bald-prince/STM32/official-account-information-master/timer/SOURCE_FILE/README.txt

1.v0.0.1  -->修改了初始化的方式，现在更加简单。
             -->修改了依赖文件，引入stdint.h 该文件里面包含uint8_t 这些变量类型，可以不再依赖于其他的文件。当前只依赖 stdlib 和 stdint这两个文件。都是c的标准文件。
