bald-prince/STM32/STM32_sumjess/HAREWARE/KEY/解释.docx

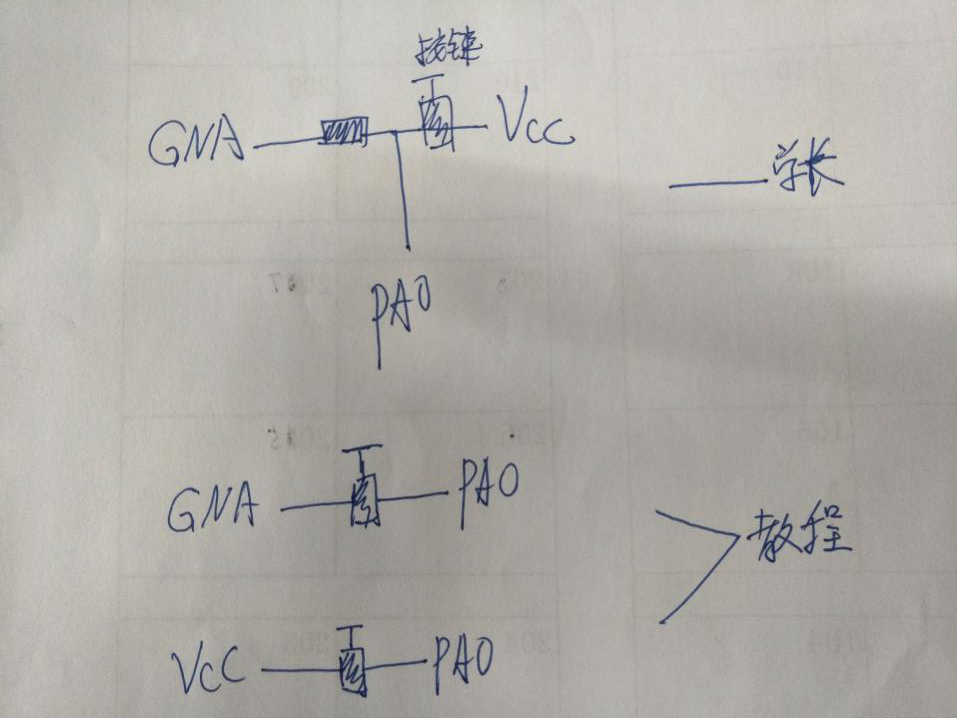
[picture p15: figure]

上拉，然后读取；方法见库中ex-key.

下拉，然后读取；方法见库中ex-key.

直接浮点数读取

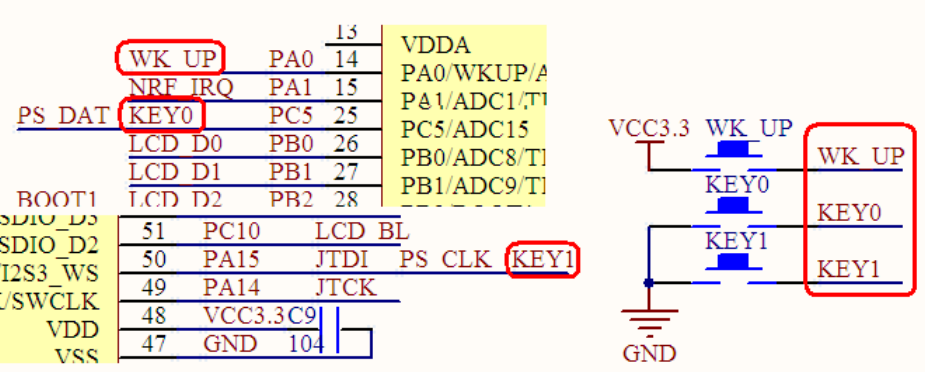
[picture p16: figure]
