bald-prince/STM32/official-account-information-master/RTT_JLINK_Printf/参考文档/HLK-V20固件命令词与播报词格式20200817.xlsx

HLK-V20 固件命令词与播报设置内容
一、唤醒串口参数 |  |  |  | 格式如下：（严格按照该文档要求）以下为默认参数，供参考
1、唤醒词（免唤醒命令词和唤醒词总条数不超过10条）： |  |  |  | 例如：小科小科、小凌小凌、你好魔方、你好台灯、小海小海
2、唤醒回复语（最多4个）： |  |  |  | 例如：我在、 hi！我在；、嗯！我来了 （可设置或不设置）
3、免唤醒的命令词（无需唤醒，说出命令词即可控制设备，需要在添加命令内选择）: |  |  |  | 例如：打开灯、关闭灯 （可设置或不设置）
4、通信波特率（4800 9600 19200 38400 57600 115200可选）： |  |  |  | 例如：115200bps，一位起始位，8位数据位，一位结束位，无校验位。
5、导航播报语（最多30个字）： |  |  |  | 例如：欢迎使用海凌科语音模块 （可设置或不设置）
6、超时退出时间（5-60s）： |  |  |  | 例如：10S （必须设置）
7、超时退出回复（最多两条）： |  |  |  | 例如：有需要再叫我、再见 （可设置或不设置）
8、主动退出退出命令（最多三条）： |  |  |  | 例如：退下、再见、关闭 （可设置或不设置）
9、主动退出回复（最多两条）： |  |  |  | 例如：有需要再叫我、再见 （可设置或不设置）
二、离线命令词与播报答复列表
action | 命令词 | 播报语 | 自定义串口输出协议 | 输出IO口（高低电平或脉冲）
语法格式：action=命令词1|命令词2...@回复语 （action、命令词、回复语均由用户定义） |  |  | 数值为16进制无0x格式 例：00 01 0A（需要空格）数值不超过16个客户可自行定义（可设置可不设置） | 不改代码仅生成固件情况下可用 B0 B1默认为串口输出串口协议 A25 A26 A27 B2 B3 B6 B7引脚为 GPIO 或B2 B3引脚为 PWM A25 A26 A27 B6 B7引脚为 GPIO
text1=风扇调到一档|一挡风|风速调到最小@好的，风扇已调到一档 |  |  |  | B3 PWM设置为40%
text2=增大风速@风速已增加百分之十 |  |  |  | B2 PWM 增加10%
text3=开灯|打开灯@好的，灯已打开 |  |  |  | B2 PWM设置为100%
text4=一小时后开灯|定时一小时开灯@已设置 |  |  | 42 03 01 BC 04 00 00 00 FF 00 03 FB | B7输出高电平
text5=关灯|关闭灯@好的，灯已关闭 |  |  |  | A27输出低电平
text6=打开开关|把开关打开|打开插座@好的 |  |  |  | A25输出周期100ms、次数1次的高电平脉冲（占空比固定为50%）
volumeUpUni=增大音量|加大音量|音量增大|提高音量@好的 |  |  | 4F 00 01
volumeDownUni=减小音量|音量减小@好的 |  |  | 4F 00 02
volumeMinUni=最小音量|音量最小|音量调到最小@好的 |  |  | 4F 00 03
volumeMaxUni=最大音量|音量最大|音量调到最打@好的 |  |  | 4F 00 04
...
...
1. action由英文、下划线“_”和数字组成，必须英文开头，不区分大小写，15个字符内
2. 命令词最多支持150条，每条限 2 - 10 个字符，仅支持中文
3. 一个action最多支持一个”@”定义回复语，单条回复语不得超过500个字符，支持中英文、数字、逗号、句号、问号
4.如果要调整设备音量，请将action设置为volumeUpUni（增大音量）、volumeDownUni（减小音量）、 volumeMaxUni（最大音量）、volumeMidUni（中等音量）、volumeMinUni（最小音量），否则不生效（无法设置静音）
5.IO口设为脉冲时，请提供脉冲的周期以及次数（占空比50%），以及脉冲输出高还是低；PWM设置时，请提供PWM频率以及占空比为高电平或低电平。
 |  |  |  |  | 已减小音量 | 1F
 |  |  |  |  | 已最大音量 | 20
 |  |  |  |  | 已最小音量 | 21
 |  |  |  |  | 风扇已打开 | 22
 |  |  |  |  | 风扇已关闭 | 23
 |  |  |  |  | 风速已调到1档 | 24
 |  |  |  |  | 风速已调到3档 | 25
 |  |  |  |  | 空调已打开 | 26
 |  |  |  |  | 空调已关闭 | 27
 |  |  |  |  | 已设置 | 28
 |  |  |  |  | 已设置 | 29
 |  |  |  |  | 已设置 | 2A
 |  |  |  |  | 已设置 | 2B
 |  |  |  |  | 已设置 | 2C
 |  |  |  |  | 浴霸已打开 | 2D
 |  |  |  |  | 浴霸已关闭 | 2E
 |  |  |  |  | 照明已打开 | 2F
 |  |  |  |  | 照明已关闭 | 30
 |  |  |  |  | 暖气已打开 | 31
 |  |  |  |  | 暖气已关闭 | 32
 |  |  |  |  | 吹风已打开 | 33
 |  |  |  |  | 吹风已关闭 | 34
 |  |  |  |  | 饮水机已打开 | 35
 |  |  |  |  | 饮水机已关闭 | 36
 |  |  |  |  | 好的 | 37
 |  |  |  |  | 好的 | 38
 |  |  |  |  | 电饭煲已打开 | 39
 |  |  |  |  | 电饭煲已关闭 | 3A
 |  |  |  |  | 好的 | 3B
 |  |  |  |  | 好的 | 3C
 |  |  |  |  | 好的 | 3D
 |  |  |  |  | 好的 | 3E
 |  |  |  |  | 开关已打开 | 3F
 |  |  |  |  | 开关已关闭 | 40
 |  |  |  |  | 好的 | 41
 |  |  |  |  | 好的 | 42
 |  |  |  |  | 好的 | 43
 |  |  |  |  | 好的 | 44
 |  |  |  |  | 好的 | 45
 |  |  |  |  | 好的 | 46
 |  |  |  |  | 已设置 | 47
 |  |  |  |  | 已设置 | 48
 |  |  |  |  | 已设置 | 49
 |  |  |  |  | 已设置 | 4A
 |  |  |  |  | 紧急呼叫已打开 | 4B
 |  |  |  |  | 我先离开，主人有事再叫我 | 发送：无 接收：无 | B2输出低电平
