bald-prince/STM32/official-account-information-master/RTT_JLINK_Printf/参考文档/使用说明/使用说明/HLK-V20 Demo固件命令词与播报词 V1.1.xlsx

HLK-V20 demo固件命令词与播报答复介绍
一、操作流程
1、给测试底板通电，模块开机启动后播报“欢迎使用海凌科语音模块”
2、使用默认的唤醒词唤醒，demo演示固件的命令词最多支持150条，一次唤醒可以多次交互
3、唤醒词支持5个：小科小科、小凌小凌、你好魔方、你好台灯、小海小海，唤醒回复语：我在
4、免唤醒的命令词(无需唤醒，说出命令词即可控制设备):打开灯光、关闭灯光
二、离线命令词与播报答复列表
序号 | 命令词 | 播报语 | action(与串口协议相关)
1 | 打开风扇 | 已为您打开风扇 | openElectricfan
2 | 关闭风扇 | 已为您关闭风扇 | closElectricfan
3 | 风扇调到1档 | 好的，风速已调到1档 | AdjustGearmin
 | 1档风
 | 风速调到最小
4 | 风扇调到3档 | 好的，风速已调到3档 | AdjustGearmax
 | 3档风
 | 风速调到最大
5 | 定时一小时关灯 | 已设置 | settiCLonehonor
6 | 定时一小时开灯 | 已设置 | settiOPonehonor
7 | 增大音量 | 好的，已增大音量 | volumeUpUni
 | 加大音量
 | 音量增大
 | 提高音量
8 | 减小音量 | 好的，已减小音量 | volumeDownUni
 | 音量减小
9 | 打开空调 | 已为您打开空调 | openkongtiao
10 | 关闭空调 | 已为您关闭空调 | closekongtiao
11 | 自动模式 | 已设置 | zhidongmos
12 | 制冷模式 | 已设置 | zhilenmos
13 | 制热模式 | 已设置 | zhirmos
14 | 升高温度 | 已设置 | shenggaowendu
15 | 降低温度 | 已设置 | jiandiwendu
16 | 打开台灯 | 台灯已打开 | turnon
17 | 关闭台灯 | 台灯已关闭 | turnoff
18 | 打开灯光 | 已为您打开灯 | openled
 | 开灯
 | 把灯打开
19 | 关灯 | 已为您关闭灯 | closeled
 | 关闭灯光
 | 把灯关闭
20 | 调到最亮 | 好的 | setmaxld
21 | 调到最暗 | 好的 | setminld
22 | 亮一点 | 好的 | zengjialiangdu
 | 增加亮度
23 | 调暗一点 | 好的 | jianxiaoliangdu
 | 减小亮度
24 | 灯调为红色 | 好的 | setcolorred
 | 把灯调为红色
 | 灯红色
 | 红色
25 | 打开浴霸 | 已为您打开浴霸 | dakaiyuba
26 | 关闭浴霸 | 已为您关闭浴霸 | guanbiyuba
27 | 打开照明 | 已为您打开照明 | dakaizaoming
28 | 关闭照明 | 已为您关闭照明 | guanbizhaoming
29 | 打开暖气 | 已为您打开暖气 | dakainuanqi
30 | 关闭暖气 | 已为您关闭暖气 | guanbinuanq
31 | 打开吹风 | 已为您打开吹风 | dakaicfeng
32 | 关闭吹风 | 已为您关闭吹风 | guanbicfeng
33 | 打开饮水机 | 已为您打开饮水机 | dakaiyingsji
34 | 关闭饮水机 | 已为您关闭饮水机 | guanbiyingsji
35 | 开始出水 | 好的 | kaishichus
36 | 停止出水 | 好的 | tingzchus
37 | 打开电饭煲 | 已为您打开电饭煲 | dakdianfangbao
38 | 关闭电饭煲 | 已为您关闭电饭煲 | guabdianfangbao
39 | 保温模式 | 好的 | baowenmos
40 | 煲汤模式 | 好的 | baotangmos
41 | 煮饭模式 | 好的 | zhufangmos
42 | 煮粥模式 | 好的 | zhuzhoumos
43 | 打开开关 | 已为您打开开关 | dakaikaiguan
44 | 关闭开关 | 已为您关闭开关 | guanbikaiguan
45 | 打开杀菌 | 好的 | dakaishaj
46 | 关闭杀菌 | 好的 | guanbishaj
47 | 打开烘干 | 好的 | dakaihonggan
48 | 关闭烘干 | 好的 | guanbihonggan
49 | 打开除臭 | 好的 | dakaichuchou
50 | 关闭除臭 | 好的 | gaunbichuchou
51 | 最大音量 | 好的 | volumeMaxUni
52 | 最小音量 | 好的 | volumeMinUni
53 | 一小时后开机 | 已设置 | settiOonehonor
54 | 一小时后关机 | 已设置 | settiConehonor | settiOonehonor
55 | 温度设置为20度 | 已设置 | tempset20
 | 温度二十度
 | 二十度
56 | 设置十五度 | 已设置 | TempSet15
 | 十五度
 | 温度设置为15度
57 | 退下 | 有需要再叫我 | exitUni
 | 再见
