bald-prince/STM32/(list of files, drawings)

Other design files:
official-account-information-master/HLINK-V20/参考文档/硬件资料/硬件资料/模块封装/HLK-V20 通用PCB封装.PcbLib
official-account-information-master/HLINK-V20/参考文档/硬件资料/硬件资料/模块封装/HLK-V20_PIN 插件PCB封装.PcbLib
official-account-information-master/HLINK-V20/参考文档/硬件资料/硬件资料/模块封装/HLK-V20_SMT 贴片PCB封装.PcbLib
official-account-information-master/HW-TEST/参考文档/硬件资料/硬件资料/模块封装/HLK-V20 通用PCB封装.PcbLib
official-account-information-master/HW-TEST/参考文档/硬件资料/硬件资料/模块封装/HLK-V20_PIN 插件PCB封装.PcbLib
official-account-information-master/HW-TEST/参考文档/硬件资料/硬件资料/模块封装/HLK-V20_SMT 贴片PCB封装.PcbLib
official-account-information-master/RTT_JLINK_Printf/参考文档/硬件资料/硬件资料/模块封装/HLK-V20 通用PCB封装.PcbLib
official-account-information-master/RTT_JLINK_Printf/参考文档/硬件资料/硬件资料/模块封装/HLK-V20_PIN 插件PCB封装.PcbLib
official-account-information-master/RTT_JLINK_Printf/参考文档/硬件资料/硬件资料/模块封装/HLK-V20_SMT 贴片PCB封装.PcbLib
official-account-information-master/STM32最小系统设计/Schlib1.SchLib
official-account-information-master/STM32最小系统设计/ZNXC.PcbDoc
official-account-information-master/STM32最小系统设计/ZNXC.PrjPcb
official-account-information-master/STM32最小系统设计/ZNXC.SchDoc
official-account-information-master/STM32最小系统设计/控制模块.PcbLib
official-account-information-master/STM32最小系统设计/智能小车.SchDoc
official-account-information-master/USB2TTL/USB2TTL/PCB2.PcbDoc
official-account-information-master/USB2TTL/USB2TTL/PCB3.PcbDoc
official-account-information-master/USB2TTL/USB2TTL/PCB_Project1.PrjPCB
official-account-information-master/USB2TTL/USB2TTL/Sheet1.SchDoc
official-account-information-master/USB2TTL/USB2TTL/USB2TTL.PrjPCB
official-account-information-master/USB2TTL/USB2TTL/USB2TTL.SchDoc
official-account-information-master/简易可调电源/LM2596S电源(改)/第一代/MYPOWER_Project.PrjPcb
official-account-information-master/简易可调电源/LM2596S电源(改)/第一代/PcbLib1.PcbLib
official-account-information-master/简易可调电源/LM2596S电源(改)/第一代/Schlib1.SchLib
official-account-information-master/简易可调电源/LM2596S电源(改)/第一代/Sheet1.SchDoc
