bald-prince/STM32/official-account-information-master/RTT_JLINK_Printf/Src/main.c

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
/* Includes ------------------------------------------------------------------*/
#include "main.h"
#include "tim.h"
#include "usart.h"
#include "gpio.h"

/* USER CODE BEGIN Includes */
#include "user_key.h"
#include "user_delay.h"
#include "hcsr04.h"
#include "HLINK_voice.h"
#include "common_interrupt.h"
#include "HW_Remote.h"
#include "stdio.h"
#include "string.h"
#include "SEGGER_RTT.h"

/* USER CODE END Includes */


void SystemClock_Config(void);
/**
  * @brief  The application entry point.
  * @retval int
  */
int main(void)
{
  /* USER CODE BEGIN 1 */
	uint8_t key = 0,t=0,HW_KeyValue = 0;
	float distant = 0;
	int val = 0;
	char *keystr = NULL;
  /* USER CODE END 1 */

  /* MCU Configuration--------------------------------------------------------*/

  /* Reset of all peripherals, Initializes the Flash interface and the Systick. */
  HAL_Init();

  /* Configure the system clock */
  SystemClock_Config();

  /* Initialize all configured peripherals */
  MX_GPIO_Init();
  MX_USART2_UART_Init();
  MX_TIM3_Init();
  MX_USART1_UART_Init();
  MX_TIM2_Init();
  MX_TIM7_Init();
  MX_TIM4_Init();
  /* USER CODE BEGIN 2 */
  HAL_Delay_us_init(168);
  HCSR_TRIG_LOW();
  HAL_GPIO_WritePin(Relay_Ctr_GPIO_Port, Relay_Ctr_Pin, GPIO_PIN_RESET);
  Voice_RecUartInit();
  HAL_TIM_Base_Start(&htim3);
//  HAL_TIM_PWM_Start(&htim3,TIM_CHANNEL_1);
  HAL_TIM_PWM_Start(&htim3,TIM_CHANNEL_3);
//  HAL_TIM_PWM_Start(&htim3,TIM_CHANNEL_2);
	RemoteInit();

  /* USER CODE END 2 */

  /* Infinite loop */
  /* USER CODE BEGIN WHILE */
  while (1)
  {
    /* USER CODE END WHILE */

    /* USER CODE BEGIN 3 */
	
		
		/*********************************************
		//以下是超声波测试代码
		**********************************************/
		//distant =  Distance(5);
		/**********************************************/
		
		/*********************************************
		//以下是按键控制舵机测试代码
		**********************************************/
//		key=KEY_Scan(0);
//		switch (key)
//		{
//			case WKUP_PRES:			//
//				PWM_Output(4,1);
//				printf("rotate -90度\r\n");
//				break;
//			case KEY2_PRES:			//
//				PWM_Output(4,2);
//				printf("rotate -45度\r\n");

//				break;
//			case KEY1_PRES:			// 
//				PWM_Output(4,4);
//				printf("rotate 45度\r\n");
//				break;
//			case KEY0_PRES:			//
//				PWM_Output(4,5);
//				printf("rotate 90度\r\n");	
//				break;
//		}
//		t++;
//		if(t%50==0)
//		{
//			t=0;
//			//printf("\r\n\r\n---------------start--------------------\r\n\r\n");
//			//printf("The Mesure Distant is:%.2f cm\r\n",distant);
//			//printf("\r\n\r\n----------------stop--------------------\r\n\r\n");
//			HAL_GPIO_TogglePin(led_run_GPIO_Port,led_run_Pin);
//		}
//		/**********************************************/
//		
//		/*********************************************
//		//以下是离线语音控制测试代码
//		**********************************************/
//		//Voice_DataFrame();
//		/*********************************************
//		
//		
//		//以下是红外控制舵机测试代码
//		**********************************************/
//		HW_KeyValue=Remote_Scan();
//		
//		if(HW_KeyValue)
//		{
//			keystr = KeyValueConvert(HW_KeyValue);
//			
//			if(!memcmp(keystr,"*",strlen("*")))
//			{
//				PWM_Stop();
//				printf("\r\nrotate stop\r\n");
//			}
//			else if(!memcmp(keystr,"UP",strlen("UP")))
//			{
//				PWM_Output(1,0);
//				PWM_Output(2,0);
//				PWM_Output(3,0);
//				PWM_Output(4,0);
//				printf("\r\nrotate 45度\r\n");
//			}
//			else if(!memcmp(keystr,"RIGHT",strlen("RIGHT")))
//			{
//				PWM_Output(1,45);
//				PWM_Output(2,45);
//				PWM_Output(3,45);
//				PWM_Output(4,45);
//				printf("\r\nrotate 90度\r\n");	
//			}	
//			else if(!memcmp(keystr,"DOWN",strlen("DOWN")))
//			{
//				PWM_Output(1,90);
//				PWM_Output(2,90);
//				PWM_Output(3,90);
//				PWM_Output(4,90);
//				printf("\r\nrotate -45度\r\n");
//			}
//			else if(!memcmp(keystr,"LEFT",strlen("LEFT")))
//			{
//				PWM_Output(1,135);
//				PWM_Output(2,135);
//				PWM_Output(3,135);
//				PWM_Output(4,135);
//				printf("\r\nrotate -90度\r\n");
//			}
//			else if(!memcmp(keystr,"OK",strlen("OK")))
//			{
//				PWM_Output(1,180);
//				PWM_Output(2,180);
//				PWM_Output(3,180);
//				PWM_Output(4,180);
//				printf("\r\nrotate 90度\r\n");
//			}	
//			printf("\r\nThe Key Value is %s \r\n",(char *)(keystr));
//		}
//		/**********************************************/
//		HAL_Delay(10);

	
		SEGGER_RTT_printf(0, RTT_CTRL_TEXT_RED"\r\n欢迎关注小飞哥玩嵌入式\r\n\r\n");
		SEGGER_RTT_printf(0, RTT_CTRL_TEXT_BRIGHT_GREEN"\r\nwelcome Embedded-party\r\n\r\n");
		SEGGER_RTT_printf(0, RTT_CTRL_TEXT_BRIGHT_BLUE"data print test:%f\r\n",12.34);	
		HAL_Delay(500);
  }
  /* USER CODE END 3 */
}

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
