bald-prince/STM32/official-account-information-master/keypad/Core/Inc/main.h

#define KEY2_Pin GPIO_PIN_2
#define KEY2_GPIO_Port GPIOE
#define KEY1_Pin GPIO_PIN_3
#define KEY1_GPIO_Port GPIOE
#define KEY0_Pin GPIO_PIN_4
#define KEY0_GPIO_Port GPIOE
#define Key_ROW1_Pin GPIO_PIN_0
#define Key_ROW1_GPIO_Port GPIOF
#define Key_ROW2_Pin GPIO_PIN_1
#define Key_ROW2_GPIO_Port GPIOF
#define Key_ROW3_Pin GPIO_PIN_2
#define Key_ROW3_GPIO_Port GPIOF
#define Key_ROW4_Pin GPIO_PIN_3
#define Key_ROW4_GPIO_Port GPIOF
#define led1_Pin GPIO_PIN_9
#define led1_GPIO_Port GPIOF
#define led2_Pin GPIO_PIN_10
#define led2_GPIO_Port GPIOF
#define WK_UP_Pin GPIO_PIN_0
#define WK_UP_GPIO_Port GPIOA
#define Key_COL1_Pin GPIO_PIN_0
#define Key_COL1_GPIO_Port GPIOG
#define Key_COL2_Pin GPIO_PIN_1
#define Key_COL2_GPIO_Port GPIOG
#define Key_COL3_Pin GPIO_PIN_2
#define Key_COL3_GPIO_Port GPIOG
#define Key_COL4_Pin GPIO_PIN_3
#define Key_COL4_GPIO_Port GPIOG
#define LCD_DC_Pin GPIO_PIN_6
#define LCD_DC_GPIO_Port GPIOG
#define LCD_CS_Pin GPIO_PIN_7
#define LCD_CS_GPIO_Port GPIOG
#define LCD_RST_Pin GPIO_PIN_8
#define LCD_RST_GPIO_Port GPIOG
