bald-prince/STM32/OLED(u8g2)/HARDWARE/OLED/oled.c

#include "oled.h"
#include "stdlib.h"
#include "delay.h"
#include "oledfont.h"
#include "QR_Encode.h" 



//OLED的显存
//存放格式如下.
//[0]0 1 2 3 ... 127	
//[1]0 1 2 3 ... 127	
//[2]0 1 2 3 ... 127	
//[3]0 1 2 3 ... 127	
//[4]0 1 2 3 ... 127	
//[5]0 1 2 3 ... 127	
//[6]0 1 2 3 ... 127	
//[7]0 1 2 3 ... 127 		   
u8 OLED_GRAM[128][8];	 

//更新显存到LCD		 
void OLED_Refresh_Gram(void)
{
	u8 i,n;		    
	for(i=0;i<8;i++)  
	{  
		OLED_WR_Byte (0xb0+i,OLED_CMD);    //设置页地址（0~7）
		OLED_WR_Byte (0x00,OLED_CMD);      //设置显示位置—列低地址
		OLED_WR_Byte (0x10,OLED_CMD);      //设置显示位置—列高地址   
		for(n=0;n<128;n++)
			OLED_WR_Byte(OLED_GRAM[n][i],OLED_DATA); 
	}   
}
#if OLED_MODE==1	//8080并口
//通过拼凑的方法向OLED输出一个8位数据
//data:要输出的数据
void OLED_Data_Out(u8 data)
{
		u16 dat=data&0X0F;
		GPIOC->ODR&=~(0XF<<6);		//清空6~9
		GPIOC->ODR|=dat<<6;			//D[3:0]-->PC[9:6]
    
    GPIOC->ODR&=~(0X1<<11);		//清空11
    GPIOC->ODR|=((data>>4)&0x01)<<11;
    
    GPIOD->ODR&=~(0X1<<3);		//清空3
    GPIOD->ODR|=((data>>5)&0x01)<<3;
    
    GPIOB->ODR&=~(0X3<<8);		//清空8,9
    GPIOB->ODR|=((data>>6)&0x01)<<8;
    GPIOB->ODR|=((data>>7)&0x01)<<9;
} 
//向SSD1306写入一个字节。
//dat:要写入的数据/命令
//cmd:数据/命令标志 0,表示命令;1,表示数据;
void OLED_WR_Byte(u8 dat,u8 cmd)
{
	OLED_Data_Out(dat);	
 	OLED_RS=cmd;
	OLED_CS=0;	
	OLED_WR=0;	  
	OLED_WR=1;   
	OLED_CS=1;   
	OLED_RS=1;   
} 	    	    
#else
//向SSD1306写入一个字节。
//dat:要写入的数据/命令
//cmd:数据/命令标志 0,表示命令;1,表示数据;
void OLED_WR_Byte(u8 dat,u8 cmd)
{	
	u8 i;			  
	OLED_RS=cmd; //写命令 
	OLED_CS=0;		  
	for(i=0;i<8;i++)
	{			  
		OLED_SCLK=0;
		if(dat&0x80)OLED_SDIN=1;
		else OLED_SDIN=0;
		OLED_SCLK=1;
		dat<<=1;   
	}				 
	OLED_CS=1;		  
	OLED_RS=1;   	  
} 


#endif
	
void OLED_Set_Pos(unsigned char x, unsigned char y) 
{ 
	OLED_WR_Byte(0xb0+y,OLED_CMD);
	OLED_WR_Byte(((x&0xf0)>>4)|0x10,OLED_CMD);
	OLED_WR_Byte((x&0x0f)|0x01,OLED_CMD); 
} 

//开启OLED显示    
void OLED_Display_On(void)
{
	OLED_WR_Byte(0X8D,OLED_CMD);  //SET DCDC命令
	OLED_WR_Byte(0X14,OLED_CMD);  //DCDC ON
	OLED_WR_Byte(0XAF,OLED_CMD);  //DISPLAY ON
}
//关闭OLED显示     
void OLED_Display_Off(void)
{
	OLED_WR_Byte(0X8D,OLED_CMD);  //SET DCDC命令
	OLED_WR_Byte(0X10,OLED_CMD);  //DCDC OFF
	OLED_WR_Byte(0XAE,OLED_CMD);  //DISPLAY OFF
}		   			 
//清屏函数,清完屏,整个屏幕是黑色的!和没点亮一样!!!	  
void OLED_Clear(void)  
{  
	u8 i,n;  
	for(i=0;i<8;i++)for(n=0;n<128;n++)OLED_GRAM[n][i]=0X00;  
	OLED_Refresh_Gram();//更新显示
}
//画点 
//x:0~127
//y:0~63
//t:1 填充 0,清空				   
void OLED_DrawPoint(u8 x,u8 y,u8 t)
{
	u8 pos,bx,temp=0;
	if(x>127||y>63)return;//超出范围了.
	pos=7-y/8;
	bx=y%8;
	temp=1<<(7-bx);
	if(t)OLED_GRAM[x][pos]|=temp;
	else OLED_GRAM[x][pos]&=~temp;	    
}
//x1,y1,x2,y2 填充区域的对角坐标
//确保x1<=x2;y1<=y2 0<=x1<=127 0<=y1<=63	 	 
//dot:0,清空;1,填充	  
void OLED_Fill(u8 x1,u8 y1,u8 x2,u8 y2,u8 dot)  
{  
	u8 x,y;  
	for(x=x1;x<=x2;x++)
	{
		for(y=y1;y<=y2;y++)OLED_DrawPoint(x,y,dot);
	}													    
	OLED_Refresh_Gram();//更新显示
}
//在指定位置显示一个字符,包括部分字符
//x:0~127
//y:0~63
//mode:0,反白显示;1,正常显示				 
//size:选择字体 12/16/24
void OLED_ShowChar(u8 x,u8 y,u8 chr,u8 size,u8 mode)
{      			    
		u8 temp,t,t1;
		u8 y0=y;
		u8 csize=(size/8+((size%8)?1:0))*(size/2);		//得到字体一个字符对应点阵集所占的字节数
		chr=chr-' ';//得到偏移后的值		 
    for(t=0;t<csize;t++)
    {   
		if(size==12)temp=asc2_1206[chr][t]; 	 	//调用1206字体
		else if(size==16)temp=asc2_1608[chr][t];	//调用1608字体
		else if(size==24)temp=asc2_2412[chr][t];	//调用2412字体
		else return;								//没有的字库
        for(t1=0;t1<8;t1++)
		{
			if(temp&0x80)OLED_DrawPoint(x,y,mode);
			else OLED_DrawPoint(x,y,!mode);
			temp<<=1;
			y++;
			if((y-y0)==size)
			{
				y=y0;
				x++;
				break;
			}
		}  	 
    }          
}
//m^n函数
u32 mypow(u8 m,u8 n)
{
	u32 result=1;	 
	while(n--)result*=m;    
	return result;
}				  
//显示2个数字
//x,y :起点坐标	 
//len :数字的位数
//size:字体大小
//mode:模式	0,填充模式;1,叠加模式
//num:数值(0~4294967295);	 		  
void OLED_ShowNum(u8 x,u8 y,u32 num,u8 len,u8 size)
{         	
	u8 t,temp;
	u8 enshow=0;						   
	for(t=0;t<len;t++)
	{
		temp=(num/mypow(10,len-t-1))%10;
		if(enshow==0&&t<(len-1))
		{
			if(temp==0)
			{
				OLED_ShowChar(x+(size/2)*t,y,' ',size,1);
				continue;
			}else enshow=1; 
		 	 
		}
	 	OLED_ShowChar(x+(size/2)*t,y,temp+'0',size,1); 
	}
} 
//显示字符串
//x,y:起点坐标  
//size:字体大小 
//*p:字符串起始地址 
void OLED_ShowString(u8 x,u8 y,const u8 *p,u8 size)
{	
	while((*p>=' '))//判断是不是非法字符!
  {       
		if(x > (128-(size/2) ) )
		{
			x = 0;
			y += size;
		}
    if(y > (64-size) )
		{
			y = x = 0;
			OLED_Clear();
		}
    OLED_ShowChar(x,y,*p,size,1);	 
    x+=size/2;
    p++;
    }  
	
}	
//显示汉字
void OLED_ShowChinese(u8 x,u8 y,u8 chr,u8 size,u8 mode)
{      			    
	u8 temp,t,t1;
	u8 y0=y;
	u8 csize=(size/8+((size%8)?1:0))*size;		//得到字体一个字符对应点阵集所占的字节数
	chr=chr-'0';//得到偏移后的值		 
	for(t=0;t<csize;t++)							//显示点阵库的中的该字符，先通过chr=chr-' '确定字符在点阵库中的行数，接着显示字符所在行的全部数据
	{   
		if(size==16)temp=asc2_1616[chr][t];	//调用1608字体
		 for(t1=0;t1<8;t1++)							//显示显示字符所在行的全部数据
		{
			if(temp&0x80)OLED_DrawPoint(x,y,mode);	//显示一个字节的数据从高位开始开始判断，如果为1则在x,y位置点亮，为0不点亮
			else OLED_DrawPoint(x,y,!mode);
			temp<<=1;   								//左移一位，为扫描下一个点数据
			y++;     										//格点下移
			if((y-y0)==size)            //控制y轴最大扫描数
			{
				y=y0;
				x++;
				break;
			}
		}  	 
	}  	
}

//在指定位置，显示一个24*24大小的汉字
//x,y :汉字的坐标
//index:汉字编号（在字库数组里面的编号） 
void OLED_ShowChinese2424(u16 x,u16 y,u8 index,u8 size)
{
	u8 temp,t,t1;
	u16 y0=y;
	u8 *dzk;   
	u8 csize=(size/8+((size%8)?1:0))*size; //一个24*24的汉字72字节 
	if(size == 12) dzk=(u8*)Chinese_1212[index];        //得到汉字编号对应的点阵库 
	else if(size == 16)	dzk=(u8*)Chinese_1616[index];   //得到汉字编号对应的点阵库 
	else if(size == 24) dzk=(u8*)Chinese_2424[index];   //得到汉字编号对应的点阵库 
//	dzk=(u8*)Chinese_2424[index];        //得到汉字编号对应的点阵库 
	for(t=0;t<csize;t++)
	{                                                                                                      
		temp=dzk[t];                                //得到点阵数据                          
		for(t1=0;t1<8;t1++)                        //按照从高位到低位的顺序画点
		{
			if(temp&0x80)OLED_DrawPoint(x,y,1);
			else OLED_DrawPoint(x,y,0); 
			temp<<=1;
			y++;
			if((y-y0)==size)                        //对y坐标的处理，当y坐标距起始坐标差24个像素点，x坐标加1
			{
				y=y0;
				x++;
				break;
			}
		}           
	}	  
}


/* -------------------------------- begin  -------------------------------- */
/**
  * @Name    OLED_ShowPicture
  * @brief  
  * @param   x: 图片起始X坐标 
**			 y: 图片起始Y坐标 
**			 sizex: 图片长 
**			 sizey: 图片宽 
**			 BMP[]: 图片数组 
**			 mode: 显示模式，0：反色显示；1：正常显示 
  * @retval
  * @author  YCL
  * @Data    2022-05-24
 **/
/* -------------------------------- end -------------------------------- */
void OLED_ShowPicture(u8 x,u8 y,u8 sizex,u8 sizey,u8 BMP[],u8 mode)
{
	u16 j = 0;
	u8 i,n,temp,m;
	u8 x0 = x,y0 = y;
	sizey = sizey/8+((sizey%8?1:0));
	for(n  = 0;n < sizey;n++)
	{
		for(i = 0;i < sizex;i++)
		{
			temp = BMP[j];
			j++;
			for(m = 0;m < 8;m++)
			{
				if(temp&0x01)
					OLED_DrawPoint(x,y,mode);
				else
					OLED_DrawPoint(x,y,!mode);
				temp>>=1;
				y++;
			}
			x++;
			if((x - x0) == sizex)
			{
				x = x0;
				y0 = y0+8;
			}
			 y = y0;
		}
	}
}

//显示二维码，网站长度不能太长，二维码只支持支付宝扫码
void OLED_DrawQRCode(char *website,int mode)
{
//  MAX_MODULESIZE = 33;
//  m_byModuleData[MAX_MODULESIZE][MAX_MODULESIZE];
    u8 i,j;
    EncodeData(website);
    for(i = 0; i < MAX_MODULESIZE; i++)
    {
        for(j = 0; j < MAX_MODULESIZE; j++)
        {
            if(m_byModuleData[i][j] == 1)
            {
            //2倍放大，1个点放大为4个点
                OLED_DrawPoint(2*i, 2*j,mode);
                OLED_DrawPoint(2*i, 2*j+1,mode);        
                OLED_DrawPoint(2*i+1, 2*j,mode);  
                OLED_DrawPoint(2*i+1, 2*j+1,mode);
//            OLED_DrawPoint_QRcode(2*i, 2*j, m_byModuleData[i][j]);
//            OLED_DrawPoint_QRcode(2*i, 2*j+1, m_byModuleData[i][j]);        
//            OLED_DrawPoint_QRcode(2*i+1, 2*j, m_byModuleData[i][j]);  
//            OLED_DrawPoint_QRcode(2*i+1, 2*j+1, m_byModuleData[i][j]);
            }   
        }
    }    
}
    

/*
	@brief			显示动图
	@param			x0：起始列地址
				y0：起始页地址
				x1：终止列地址
				y1：终止页地址
				k: 帧个数
				m: 单帧数组大小
				BMP[][m]：存放动图代码的数组
	@retval			无
 */
void OLED_DrawGIF(unsigned char x0, unsigned char y0,unsigned char x1, unsigned char y1, unsigned char k, int m, unsigned char GIF[][m])
{
	unsigned int j=0; //定义变量
 	unsigned char x,y,i; //定义变量
  
 	if(y1%8==0) y=y1/8;   //判断终止页是否为8的整数倍
 	 else y=y1/8+1;
	for (i=0;i<k;i++) //从第一帧开始画
	{
		j = 0;
		for(y=y0;y<y1;y++) //从起始页开始，画到终止页
		{
			OLED_Set_Pos(x0,y); //在页的起始列开始画
   			
			for(x=x0;x<x1;x++) //画x1 - x0 列
	    {
				OLED_WR_Byte(GIF[i][j++],OLED_DATA);	//画图片的点    	
	    }
		}
	}
}
/*
	@brief			显示图片
	@param			x0：起始列地址
					y0：起始页地址
					x1：终止列地址
					y1：终止页地址
					BMP[]：存放图片代码的数组
	@retval			无
 */

//有频闪
//显示BMP图片128×64起始点坐标(x,y),x的范围0～127，y为页的范围0～7
void OLED_DrawBMP(u8 x0, u8 y0, u8 x1, u8 y1, u8 BMPx[])
{
    u16 j = 0;
    u8 x, y;

    if(y1 % 8 == 0) y = y1 / 8;
    else y = y1 / 8 + 1;
    for(y = y0; y < y1; y++)
    {
        OLED_Set_Pos(x0, y);
        for(x = x0; x < x1; x++)
        {
            //OLED_WriteData(BMPx[j++]);
					OLED_WR_Byte(BMPx[j++],OLED_DATA);
        }
    }
}

void OLED_ShowFloat(u8 x,u8 y,float num,u8 size)//显示float
{
	char temp[10];
  sprintf(temp,"%-5.3f",num);
  OLED_ShowString(x,y,(u8 *)temp,size);
}

//初始化SSD1306					    
void OLED_Init(void)
{ 	 		 
	  GPIO_InitTypeDef GPIO_Initure;
    __HAL_RCC_GPIOA_CLK_ENABLE();   //使能GPIOA时钟
    __HAL_RCC_GPIOB_CLK_ENABLE();   //使能GPIOB时钟
    __HAL_RCC_GPIOC_CLK_ENABLE();   //使能GPIOC时钟
    __HAL_RCC_GPIOD_CLK_ENABLE();   //使能GPIOD时钟
    __HAL_RCC_GPIOE_CLK_ENABLE();   //使能GPIOE时钟
    
#if OLED_MODE==1		//使用8080并口模式		
	
	  //GPIO初始化设置      
    GPIO_Initure.Pin=GPIO_PIN_15;         //PA15
    GPIO_Initure.Mode=GPIO_MODE_OUTPUT_PP;//推挽输出
    GPIO_Initure.Pull=GPIO_PULLUP;        //上拉
    GPIO_Initure.Speed=GPIO_SPEED_FAST;   //快速
    HAL_GPIO_Init(GPIOA,&GPIO_Initure);   //初始化
	
    //PB3,4,7,8,9
    GPIO_Initure.Pin=GPIO_PIN_3|GPIO_PIN_4|GPIO_PIN_7|GPIO_PIN_8|GPIO_PIN_9;	
	  HAL_GPIO_Init(GPIOB,&GPIO_Initure);//初始化

    //PC6,7,8,9,11
    GPIO_Initure.Pin=GPIO_PIN_6|GPIO_PIN_7|GPIO_PIN_8|GPIO_PIN_9|GPIO_PIN_11;	
   	HAL_GPIO_Init(GPIOC,&GPIO_Initure);//初始化	
  
    //PD3
	  GPIO_Initure.Pin=GPIO_PIN_3;	
	  HAL_GPIO_Init(GPIOD,&GPIO_Initure);//初始化	
	
    //PH8
	  GPIO_Initure.Pin=GPIO_PIN_8;	
	  HAL_GPIO_Init(GPIOH,&GPIO_Initure);//初始化	
	
	  OLED_WR=1;
  	OLED_RD=1; 
#else					//使用4线SPI 串口模式
		//GPIO初始化设置      
		GPIO_Initure.Pin=GPIO_PIN_12|GPIO_PIN_11|GPIO_PIN_10;
    GPIO_Initure.Mode=GPIO_MODE_OUTPUT_PP;//推挽输出
    GPIO_Initure.Pull=GPIO_PULLUP;        //上拉
    GPIO_Initure.Speed=GPIO_SPEED_FAST;   //高速
    HAL_GPIO_Init(GPIOB,&GPIO_Initure);//初始化
	
    //PB4,7
    //PC6,7
    GPIO_Initure.Pin=GPIO_PIN_12|GPIO_PIN_13;	
	  HAL_GPIO_Init(GPIOD,&GPIO_Initure);//初始化	

		OLED_SDIN=1;
		OLED_SCLK=1;
#endif
	OLED_CS=1;
	OLED_RS=1;	 
	
	OLED_RST=0;
	delay_ms(100);
	OLED_RST=1; 
					  
	OLED_WR_Byte(0xAE,OLED_CMD); //关闭显示
	OLED_WR_Byte(0xD5,OLED_CMD); //设置时钟分频因子,震荡频率
	OLED_WR_Byte(80,OLED_CMD);   //[3:0],分频因子;[7:4],震荡频率
	OLED_WR_Byte(0xA8,OLED_CMD); //设置驱动路数
	OLED_WR_Byte(0X3F,OLED_CMD); //默认0X3F(1/64) 
	OLED_WR_Byte(0xD3,OLED_CMD); //设置显示偏移
	OLED_WR_Byte(0X00,OLED_CMD); //默认为0
	OLED_WR_Byte(0x40,OLED_CMD); //设置显示开始行 [5:0],行数.										    
	OLED_WR_Byte(0x8D,OLED_CMD); //电荷泵设置
	OLED_WR_Byte(0x14,OLED_CMD); //bit2，开启/关闭
	OLED_WR_Byte(0x20,OLED_CMD); //设置内存地址模式
	OLED_WR_Byte(0x02,OLED_CMD); //[1:0],00，列地址模式;01，行地址模式;10,页地址模式;默认10;
	OLED_WR_Byte(0xA1,OLED_CMD); //段重定义设置,bit0:0,0->0;1,0->127;
	OLED_WR_Byte(0xC0,OLED_CMD); //设置COM扫描方向;bit3:0,普通模式;1,重定义模式 COM[N-1]->COM0;N:驱动路数
	OLED_WR_Byte(0xDA,OLED_CMD); //设置COM硬件引脚配置
	OLED_WR_Byte(0x12,OLED_CMD); //[5:4]配置	 
	OLED_WR_Byte(0x81,OLED_CMD); //对比度设置
	OLED_WR_Byte(0xEF,OLED_CMD); //1~255;默认0X7F (亮度设置,越大越亮)
	OLED_WR_Byte(0xD9,OLED_CMD); //设置预充电周期
	OLED_WR_Byte(0xf1,OLED_CMD); //[3:0],PHASE 1;[7:4],PHASE 2;
	OLED_WR_Byte(0xDB,OLED_CMD); //设置VCOMH 电压倍率
	OLED_WR_Byte(0x30,OLED_CMD); //[6:4] 000,0.65*vcc;001,0.77*vcc;011,0.83*vcc;
	OLED_WR_Byte(0xA4,OLED_CMD); //全局显示开启;bit0:1,开启;0,关闭;(白屏/黑屏)
	OLED_WR_Byte(0xA6,OLED_CMD); //设置显示方式;bit0:1,反相显示;0,正常显示	    						   
	OLED_WR_Byte(0xAF,OLED_CMD); //开启显示	 
	OLED_Clear();
}  

uint8_t u8x8_stm32_gpio_and_delay(U8X8_UNUSED u8x8_t *u8x8,U8X8_UNUSED uint8_t msg, U8X8_UNUSED uint8_t arg_int,U8X8_UNUSED void *arg_ptr)
{
  switch (msg)
  {
		case U8X8_MSG_GPIO_SPI_DATA:
			(arg_int)?SET_BIT(GPIOD->ODR,GPIO_PIN_13):CLEAR_BIT(GPIOD->ODR,GPIO_PIN_13);   //D1
			break;
		case U8X8_MSG_GPIO_SPI_CLOCK:
			(arg_int)?SET_BIT(GPIOD->ODR,GPIO_PIN_12):CLEAR_BIT(GPIOD->ODR,GPIO_PIN_12);
			break;
		case U8X8_MSG_GPIO_AND_DELAY_INIT:
					OLED_Init();
					HAL_Delay(1);
			break;
		case U8X8_MSG_DELAY_MILLI:
			HAL_Delay(arg_int);
			break;
			case U8X8_MSG_GPIO_CS:
				(arg_int)?SET_BIT(GPIOB->ODR,GPIO_PIN_12):CLEAR_BIT(GPIOB->ODR,GPIO_PIN_12);
		case U8X8_MSG_GPIO_DC:
					(arg_int)?SET_BIT(GPIOB->ODR,GPIO_PIN_11):CLEAR_BIT(GPIOB->ODR,GPIO_PIN_11);
			break;
		case U8X8_MSG_GPIO_RESET:
					(arg_int)?SET_BIT(GPIOB->ODR,GPIO_PIN_10):CLEAR_BIT(GPIOB->ODR,GPIO_PIN_10);
			break;
  }
  return 1;
}

void u8g2Init(u8g2_t *u8g2)
{
	u8g2_Setup_ssd1306_128x64_noname_f(u8g2,U8G2_R0,u8x8_byte_4wire_sw_spi,u8x8_stm32_gpio_and_delay);//初始化u8g2
	u8g2_InitDisplay(u8g2); // 根据所选的芯片进行初始化工作，初始化完成后，显示器处于关闭状态
	u8g2_SetPowerSave(u8g2, 0); // 打开显示器
	u8g2_ClearBuffer(u8g2);
}

/*官方提供的Log绘制demo*/
void draw(u8g2_t *u8g2)
{
    u8g2_SetFontMode(u8g2, 1); /*字体模式选择*/
    u8g2_SetFontDirection(u8g2, 0); /*字体方向选择*/
    u8g2_SetFont(u8g2, u8g2_font_inb24_mf); /*字库选择*/
    u8g2_DrawStr(u8g2, 0, 20, "U");
    
    u8g2_SetFontDirection(u8g2, 1);
    u8g2_SetFont(u8g2, u8g2_font_inb30_mn);
    u8g2_DrawStr(u8g2, 21,8,"8");
        
    u8g2_SetFontDirection(u8g2, 0);
    u8g2_SetFont(u8g2, u8g2_font_inb24_mf);
    u8g2_DrawStr(u8g2, 51,30,"g");
    u8g2_DrawStr(u8g2, 67,30,"\xb2");
    
    u8g2_DrawHLine(u8g2, 2, 35, 47);
    u8g2_DrawHLine(u8g2, 3, 36, 47);
    u8g2_DrawVLine(u8g2, 45, 32, 12);
    u8g2_DrawVLine(u8g2, 46, 33, 12);
  
    u8g2_SetFont(u8g2, u8g2_font_4x6_tr);
    u8g2_DrawStr(u8g2, 1,54,"github.com/olikraus/u8g2");
}
