bald-prince/STM32/LED/HARDWARE/LED/led.h

#ifndef _LED_H
#define _LED_H
#include "sys.h"

#define LED0 PCout(0)
#define LED1 PCout(1)
#define LED2 PCout(2)
#define LED3 PCout(3)
#define LED4 PCout(4)
#define LED5 PCout(5)
#define LED6 PCout(6)
#define LED7 PCout(7)


void LED_Init(void);

#endif
