bald-prince/STM32/STM32_sumjess/HAREWARE/LED/LED.c

#include "led.h"

/*******************************************************************************
================================================================================
【平    台】stm32f103zet6_sumjess平台
【编    写】sumjess
【E-mail  】1371129880@qq.com
【软件版本】V2.0
【最后更新】2018年09月06日
【相关信息参考下列地址】
【网    站】
           https://blog.csdn.net/qq_38351824
           http://www.openedv.com/
           http://www.stmcu.org/
					 http://www.firebbs.cn/forum.php
---------------------------------------------------------------------------------
【dev.env.】MDK5.14及以上版本
【Target  】stm32f103zet6
第一次修订：2017/11/09
第二次修订：2018/01/21
第三次修订：2018/09/06
---------------------------------------------------------------------------------
没有完美的代码，只有不断的奉献，大家一起努力；
赠人玫瑰手留余香，欢迎大家反馈bug！
================================================================================
********************************************************************************/	
//LED驱动 代码	       

//初始化PB5和PE5为输出口.并使能这两个口的时钟		    
//LED IO初始化
void LED_Init(void)
{
 
 GPIO_InitTypeDef  GPIO_InitStructure;
 	
 RCC_APB2PeriphClockCmd(RCC_APB2Periph_GPIOD|RCC_APB2Periph_GPIOB, ENABLE);	 //使能PB,PE端口时钟
	
 GPIO_InitStructure.GPIO_Pin = GPIO_Pin_0|GPIO_Pin_12; //LED0-->PB8 LED1-->PB12端口配置
 GPIO_InitStructure.GPIO_Mode = GPIO_Mode_Out_PP; 		 //推挽输出
 GPIO_InitStructure.GPIO_Speed = GPIO_Speed_50MHz;		 //IO口速度为50MHz
 GPIO_Init(GPIOB, &GPIO_InitStructure);					       //根据设定参数初始化GPIOB.8
 GPIO_SetBits(GPIOB,GPIO_Pin_0);						           //PB.8 输出高

 GPIO_InitStructure.GPIO_Pin = GPIO_Pin_13;	    		   //LED1-->PE.2 端口配置, 推挽输出
 GPIO_Init(GPIOD, &GPIO_InitStructure);	  				     //推挽输出 ，IO口速度为50MHz
 GPIO_ResetBits(GPIOD,GPIO_Pin_13); 						           //PE.2 输出高 
}
void relay_Init(void)
{
 
 GPIO_InitTypeDef  GPIO_InitStructure;
 	
 RCC_APB2PeriphClockCmd(RCC_APB2Periph_GPIOD, ENABLE);	 //使能PB,PE端口时钟
	
 GPIO_InitStructure.GPIO_Pin = GPIO_Pin_15; //LED0-->PB8 LED1-->PB12端口配置
 GPIO_InitStructure.GPIO_Mode = GPIO_Mode_Out_PP; 		 //推挽输出
 GPIO_InitStructure.GPIO_Speed = GPIO_Speed_50MHz;		 //IO口速度为50MHz
 GPIO_Init(GPIOD, &GPIO_InitStructure);					       //根据设定参数初始化GPIOB.8
 GPIO_ResetBits(GPIOD,GPIO_Pin_15);						           //PB.8 输出高

}
void light_Init(void)
{
 
 GPIO_InitTypeDef  GPIO_InitStructure;
 	
 RCC_APB2PeriphClockCmd(RCC_APB2Periph_GPIOC, ENABLE);	 //使能PB,PE端口时钟
	
 GPIO_InitStructure.GPIO_Pin = GPIO_Pin_4; //LED0-->PB8 LED1-->PB12端口配置
 GPIO_InitStructure.GPIO_Mode = GPIO_Mode_IN_FLOATING; 		 //推挽输出
 GPIO_InitStructure.GPIO_Speed = GPIO_Speed_50MHz;		 //IO口速度为50MHz
 GPIO_Init(GPIOC, &GPIO_InitStructure);					       //根据设定参数初始化GPIOB.8
 GPIO_ResetBits(GPIOC,GPIO_Pin_4);						           //PB.8 输出高

}  
