bald-prince/STM32/official-account-information-master/LD3320/sensor/User_Device/LD3320_Driver/ld330_drv.c/mp3.h

/******************************************************************************
************************************mp3 data***********************************
* | file      	:	mp3.h
* |	version			:	V1.0
* | date				:	2020-06-18
* | function		:	mp3 data
******************************************************************************/
#ifndef __MP3_H
#define __MP3_H

#define size_sound_1 1235	

//verygood_withHead.mp3
static unsigned char sound_1 [size_sound_1] = {
0x49,0x44,0x33,0x03,0x00,0x00,0x00,0x00,0x01,0x76,0x50,0x52,0x49,0x56,0x00,0x00,
0x00,0x0E,0x00,0x00,0x50,0x65,0x61,0x6B,0x56,0x61,0x6C,0x75,0x65,0x00,0xFF,0x7F,
0x00,0x00,0x50,0x52,0x49,0x56,0x00,0x00,0x00,0x11,0x00,0x00,0x41,0x76,0x65,0x72,
0x61,0x67,0x65,0x4C,0x65,0x76,0x65,0x6C,0x00,0xA1,0x29,0x00,0x00,0x00,0x00,0x00,
0x00,0x00,0x00,0x00,0x00,0x00,0x00,0x00,0x00,0x00,0x00,0x00,0x00,0x00,0x00,0x00,
0x00,0x00,0x00,0x00,0x00,0x00,0x00,0x00,0x00,0x00,0x00,0x00,0x00,0x00,0x00,0x00,
0x00,0x00,0x00,0x00,0x00,0x00,0x00,0x00,0x00,0x00,0x00,0x00,0x00,0x00,0x00,0x00,
0x00,0x00,0x00,0x00,0x00,0x00,0x00,0x00,0x00,0x00,0x00,0x00,0x00,0x00,0x00,0x00,
0x00,0x00,0x00,0x00,0x00,0x00,0x00,0x00,0x00,0x00,0x00,0x00,0x00,0x00,0x00,0x00,
0x00,0x00,0x00,0x00,0x00,0x00,0x00,0x00,0x00,0x00,0x00,0x00,0x00,0x00,0x00,0x00,
0x00,0x00,0x00,0x00,0x00,0x00,0x00,0x00,0x00,0x00,0x00,0x00,0x00,0x00,0x00,0x00,
0x00,0x00,0x00,0x00,0x00,0x00,0x00,0x00,0x00,0x00,0x00,0x00,0x00,0x00,0x00,0x00,
0x00,0x00,0x00,0x00,0x00,0x00,0x00,0x00,0x00,0x00,0x00,0x00,0x00,0x00,0x00,0x00,
0x00,0x00,0x00,0x00,0x00,0x00,0x00,0x00,0x00,0x00,0x00,0x00,0x00,0x00,0x00,0x00,
0x00,0x00,0x00,0x00,0x00,0x00,0x00,0x00,0x00,0x00,0x00,0x00,0x00,0x00,0x00,0x00,
0x00,0x00,0x00,0x00,0x00,0x00,0x00,0x00,0x00,0x00,0x00,0x00,0x00,0x00,0x00,0x00,
0xFF,0xE2,0x10,0xC0,0x0B,0xC1,0x00,0x07,0xF0,0x4E,0x80,0xD0,0x61,0x86,0x28,0xF3,
0xF6,0x00,0x6E,0x04,0x0E,0x4C,0xD7,0xB4,0x11,0x1C,0x82,0x17,0x76,0xC9,0x31,0x13,
0xE5,0x1C,0x18,0x5C,0x83,0xC6,0xBC,0x85,0xDB,0x91,0x3E,0x30,0x07,0x3E,0x53,0x25,
0x1C,0x16,0x0D,0x3E,0xFF,0xE2,0x10,0xC0,0x6C,0x92,0x05,0x08,0x28,0x56,0xC5,0x71,
0x4F,0x00,0x00,0x0C,0xE2,0xCE,0x23,0x6A,0x07,0xEC,0x0C,0xF1,0xDE,0x6B,0xC0,0x64,
0xCC,0x7B,0xC9,0x10,0x06,0x3C,0xFF,0xFF,0xFD,0xB1,0x50,0x20,0x20,0x5C,0xD7,0x04,
0x02,0x76,0x3A,0x95,0x88,0xF7,0x31,0xBE,0xFF,0xE2,0x12,0xC0,0x4A,0xC1,0x09,0x05,
0xB0,0x36,0xF4,0x29,0x89,0x00,0x00,0x41,0xD4,0x87,0xE8,0xFB,0xBF,0xFF,0xFF,0xE8,
0x08,0x9F,0xFF,0xD6,0x5F,0x68,0x0F,0x76,0xCD,0x0C,0x92,0x7D,0x0F,0x6E,0x54,0x82,
0xCA,0x7F,0xFF,0xFF,0xFF,0x3A,0xB1,0xE0,0xB2,0x02,0xC7,0xED,0x79,0xFF,0xE2,0x10,
0xC0,0xB5,0x38,0x18,0x07,0x90,0x47,0x04,0xB1,0xC7,0x00,0x00,0x91,0x03,0xCE,0x0A,
0x82,0x04,0x1F,0x80,0x04,0x01,0x47,0xF8,0x6B,0xC2,0x0F,0xFF,0x08,0x0F,0x6A,0x89,
0x8A,0x7F,0xFF,0xFF,0xFC,0x11,0x89,0x0C,0x8A,0x09,0x9C,0xD0,0xC4,0x42,0x6D,0x0F,
0x49,0xFF,0xE2,0x10,0xC0,0xE7,0xFC,0x1E,0x07,0xA0,0x76,0xFD,0x70,0x39,0x4A,0x48,
0x6D,0x90,0x86,0x80,0xFC,0x7E,0x0D,0xBD,0xF2,0x5D,0x4D,0xD0,0x26,0x20,0x58,0x17,
0xFF,0xEB,0x7C,0x4C,0x02,0xEA,0x48,0x2A,0xE9,0x8D,0x3F,0x60,0x1A,0x82,0xC0,0x7E,
0x22,0x09,0xEF,0x90,0xC7,0xFF,0xE2,0x10,0xC0,0xA4,0xC6,0x24,0x06,0x58,0x73,0x09,
0x90,0x10,0x4A,0x48,0xC9,0x30,0xCA,0xC6,0x06,0xD1,0xE1,0xAF,0xFE,0xB1,0xA8,0x38,
0x03,0x08,0x9D,0x20,0x84,0x4A,0x40,0x2C,0x7F,0x06,0x00,0x37,0x20,0x70,0x37,0xB1,
0x85,0x80,0x00,0x41,0x61,0xA2,0x0A,0x71,0x13,0xFF,0xE2,0x12,0xC0,0xE9,0x5B,0x2F,
0x06,0x78,0x6F,0x01,0x90,0x28,0x50,0x48,0x3B,0x3A,0x7F,0xFF,0xFF,0xFF,0xFF,0x4B,
0xAB,0x6F,0xB3,0xB1,0x99,0x50,0x47,0x0C,0xA5,0xF2,0x26,0x8A,0x02,0x3E,0xA5,0xE6,
0x23,0x3A,0x16,0xB0,0x87,0x29,0x86,0x5D,0x07,0xFC,0x86,0x8A,0xD4,0x04,0xFF,0xE2,
0x10,0xC0,0x4E,0x21,0x3B,0x09,0xC9,0x67,0x05,0x90,0x11,0x44,0x91,0x63,0x53,0xFF,
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
};

#endif
