bald-prince/STM32/STM32_sumjess/explain/ex-lcd.c

/*

*******************************************************************************
================================================================================
【平    台】stm32f103zet6_sumjess平台
【编    写】sumjess
【E-mail  】1371129880@qq.com
【软件版本】V2.0
【最后更新】2018年01月21日
【相关信息参考下列地址】
【网    站】http://www.openedv.com/
           http://www.stmcu.org/
					 http://www.firebbs.cn/forum.php
---------------------------------------------------------------------------------
【dev.env.】MDK5.14及以上版本
【Target  】stm32f103zet6
第一次修订：2017/11/09
第二次修订：2018/01/21
---------------------------------------------------------------------------------
没有完美的代码，只有不断的奉献，大家一起努力；
赠人玫瑰手留余香，欢迎大家反馈bug！
================================================================================
********************************************************************************





#include "led.h"
#include "delay.h"
#include "sys.h"
#include "usart.h"
#include "lcd.h"


 int main(void)
 { 
	 u8 x=0;
	u8 lcd_id[12];			//存放LCD ID字符串	
	delay_init();	    	 //延时函数初始化	  
	uart_init(9600);	 	//串口初始化为9600
	LED_Init();		  		//初始化与LED连接的硬件接口
 	LCD_Init();
	POINT_COLOR=RED; 
	sprintf((char*)lcd_id,"LCD ID:%04X",lcddev.id);//将LCD ID打印到lcd_id数组。				 	
  	while(1) 
	{		 
		switch(x)
		{
			case 0:LCD_Clear(WHITE);break;
			case 1:LCD_Clear(BLACK);break;
			case 2:LCD_Clear(BLUE);break;
			case 3:LCD_Clear(RED);break;
			case 4:LCD_Clear(MAGENTA);break;
			case 5:LCD_Clear(GREEN);break;
			case 6:LCD_Clear(CYAN);break;

			case 7:LCD_Clear(YELLOW);break;
			case 8:LCD_Clear(BRRED);break;
			case 9:LCD_Clear(GRAY);break;
			case 10:LCD_Clear(LGRAY);break;
			case 11:LCD_Clear(BROWN);break;
		}
		POINT_COLOR=RED;	  
		LCD_ShowString(30,40,200,24,24,"Mini STM32 ^_^");	
		LCD_ShowString(30,70,200,16,16,"TFTLCD TEST");
		LCD_ShowString(30,90,200,16,16,"sumjess");
 		LCD_ShowString(30,110,200,16,16,lcd_id);		//显示LCD ID	      					 
		LCD_ShowString(30,130,200,12,12,"2014/3/7");	      					 
	    x++;
		if(x==12)x=0;
		LED0=!LED0;	 
		delay_ms(1000);	
	} 
}





*/
