bald-prince/STM32/OLED(GuiLite)/Hello_Cricle/GuiLite.h

#pragma once
#define REAL_TIME_TASK_CYCLE_MS		50
#define MAX(a,b) (((a)>(b))?(a):(b))
#define MIN(a,b) (((a)<(b))?(a):(b))
#define GL_ARGB(a, r, g, b) ((((unsigned int)(a)) << 24) | (((unsigned int)(r)) << 16) | (((unsigned int)(g)) << 8) | ((unsigned int)(b)))
#define GL_ARGB_A(rgb) ((((unsigned int)(rgb)) >> 24) & 0xFF)
#define GL_RGB(r, g, b) ((0xFF << 24) | (((unsigned int)(r)) << 16) | (((unsigned int)(g)) << 8) | ((unsigned int)(b)))
#define GL_RGB_R(rgb) ((((unsigned int)(rgb)) >> 16) & 0xFF)
#define GL_RGB_G(rgb) ((((unsigned int)(rgb)) >> 8) & 0xFF)
#define GL_RGB_B(rgb) (((unsigned int)(rgb)) & 0xFF)
#define GL_RGB_32_to_16(rgb) (((((unsigned int)(rgb)) & 0xFF) >> 3) | ((((unsigned int)(rgb)) & 0xFC00) >> 5) | ((((unsigned int)(rgb)) & 0xF80000) >> 8))
#define GL_RGB_16_to_32(rgb) ((0xFF << 24) | ((((unsigned int)(rgb)) & 0x1F) << 3) | ((((unsigned int)(rgb)) & 0x7E0) << 5) | ((((unsigned int)(rgb)) & 0xF800) << 8))
#define ALIGN_HCENTER		0x00000000L
#define ALIGN_LEFT			0x01000000L
#define ALIGN_RIGHT			0x02000000L
#define ALIGN_HMASK			0x03000000L
#define ALIGN_VCENTER		0x00000000L
#define ALIGN_TOP			0x00100000L
#define ALIGN_BOTTOM		0x00200000L
#define ALIGN_VMASK			0x00300000L
typedef struct
{
	unsigned short year;
	unsigned short month;
	unsigned short date;
	unsigned short day;
	unsigned short hour;
	unsigned short minute;
	unsigned short second;
}T_TIME;
void register_debug_function(void(*my_assert)(const char* file, int line), void(*my_log_out)(const char* log));
void _assert(const char* file, int line);
#define ASSERT(condition)	\
	do{                     \
	if(!(condition))_assert(__FILE__, __LINE__);\
	}while(0)
void log_out(const char* log);
long get_time_in_second();
T_TIME second_to_day(long second);
T_TIME get_time();
void start_real_timer(void (*func)(void* arg));
void register_timer(int milli_second, void func(void* param), void* param);
unsigned int get_cur_thread_id();
void create_thread(unsigned long* thread_id, void* attr, void *(*start_routine) (void *), void* arg);
void thread_sleep(unsigned int milli_seconds);
int build_bmp(const char *filename, unsigned int width, unsigned int height, unsigned char *data);
#define FIFO_BUFFER_LEN		1024
class c_fifo
{
public:
	c_fifo();
	int read(void* buf, int len);
	int write(void* buf, int len);
private:
	unsigned char 	m_buf[FIFO_BUFFER_LEN];
	int		m_head;
	int		m_tail;
	void* m_read_sem;
	void* m_write_mutex;
};
class c_rect
{
public:
	c_rect(){ m_left = m_top = m_right = m_bottom = -1; }
	c_rect(int left, int top, int width, int height)
	{
		set_rect(left, top, width, height);
	}
	void set_rect(int left, int top, int width, int height)
	{
		ASSERT(width > 0 && height > 0);
		m_left = left;
		m_top = top;
		m_right = left + width - 1;
		m_bottom = top + height -1;
	}
	bool pt_in_rect(int x, int y) const
	{
		return x >= m_left && x <= m_right && y >= m_top && y <= m_bottom;
	}
	int operator==(const c_rect& rect) const
	{
		return (m_left == rect.m_left) && (m_top == rect.m_top) && (m_right == rect.m_right) && (m_bottom == rect.m_bottom);
	}
	int width() const { return m_right - m_left + 1; }
	int height() const { return m_bottom - m_top + 1 ; }
	int	    m_left;
	int     m_top;
	int     m_right;
	int     m_bottom;
};
//BITMAP
typedef struct struct_bitmap_info
{
	unsigned short width;
	unsigned short height;
	unsigned short color_bits;//support 16 bits only
	const unsigned short* pixel_color_array;
} BITMAP_INFO;
//FONT
typedef struct struct_lattice
{
	unsigned int			utf8_code;
	unsigned char			width;
	const unsigned char*	pixel_buffer;
} LATTICE;
typedef struct struct_lattice_font_info
{
	unsigned char	height;
	unsigned int	count;
	LATTICE*		lattice_array;
} LATTICE_FONT_INFO;
//Rebuild gui library once you change this file
enum FONT_LIST
{
	FONT_NULL,
	FONT_DEFAULT,
	FONT_CUSTOM1,
	FONT_CUSTOM2,
	FONT_CUSTOM3,
	FONT_CUSTOM4,
	FONT_CUSTOM5,
	FONT_CUSTOM6,
	FONT_MAX
};
enum IMAGE_LIST
{
	IMAGE_CUSTOM1,
	IMAGE_CUSTOM2,
	IMAGE_CUSTOM3,
	IMAGE_CUSTOM4,
	IMAGE_CUSTOM5,
	IMAGE_CUSTOM6,
	IMAGE_MAX
};
enum COLOR_LIST
{
	COLOR_WND_FONT,
	COLOR_WND_NORMAL,
	COLOR_WND_PUSHED,
	COLOR_WND_FOCUS,
	COLOR_WND_BORDER,
	COLOR_CUSTOME1,
	COLOR_CUSTOME2,
	COLOR_CUSTOME3,
	COLOR_CUSTOME4,
	COLOR_CUSTOME5,
	COLOR_CUSTOME6,
	COLOR_MAX
};
class c_theme
{
public:
	static int add_font(FONT_LIST index, const void* font)
	{
		if (index >= FONT_MAX)
		{
			ASSERT(false);
			return -1;
		}
		s_font_map[index] = font;
		return 0;
	}
	static const void* get_font(FONT_LIST index)
	{
		if (index >= FONT_MAX)
		{
			ASSERT(false);
			return 0;
		}
		return s_font_map[index];
	}
	static int add_image(IMAGE_LIST index, const void* image_info)
	{
		if (index >= IMAGE_MAX)
		{
			ASSERT(false);
			return -1;
		}
		s_image_map[index] = image_info;
		return 0;
	}
	static const void* get_image(IMAGE_LIST index)
	{
		if (index >= IMAGE_MAX)
		{
			ASSERT(false);
			return 0;
		}
		return s_image_map[index];
	}
	
	static int add_color(COLOR_LIST index, const unsigned int color)
	{
		if (index >= COLOR_MAX)
		{
			ASSERT(false);
			return -1;
		}
		s_color_map[index] = color;
		return 0;
	}
	static const unsigned int get_color(COLOR_LIST index)
	{
		if (index >= COLOR_MAX)
		{
			ASSERT(false);
			return 0;
		}
		return s_color_map[index];
	}
private:
	static const void* s_font_map[FONT_MAX];
	static const void* s_image_map[IMAGE_MAX];
	static unsigned int s_color_map[COLOR_MAX];
};
#include <string.h>
#include <stdio.h>
#include <stdlib.h>
#define SURFACE_CNT_MAX	6//root + pages
typedef enum
{
	Z_ORDER_LEVEL_0,//lowest graphic level
	Z_ORDER_LEVEL_1,//middle graphic level
	Z_ORDER_LEVEL_2,//highest graphic level
	Z_ORDER_LEVEL_MAX
}Z_ORDER_LEVEL;
struct DISPLAY_DRIVER
{
	void(*draw_pixel)(int x, int y, unsigned int rgb);
	void(*fill_rect)(int x0, int y0, int x1, int y1, unsigned int rgb);
};
class c_surface;
class c_display {
	friend class c_surface;
public:
	inline c_display(void* phy_fb, int display_width, int display_height, c_surface* surface, DISPLAY_DRIVER* driver = 0);//single custom surface
	inline c_display(void* phy_fb, int display_width, int display_height, int surface_width, int surface_height, unsigned int color_bytes, int surface_cnt, DISPLAY_DRIVER* driver = 0);//multiple surface
	inline c_surface* alloc_surface(Z_ORDER_LEVEL max_zorder, c_rect layer_rect = c_rect());//for slide group
	inline int swipe_surface(c_surface* s0, c_surface* s1, int x0, int x1, int y0, int y1, int offset);
	int get_width() { return m_width; }
	int get_height() { return m_height; }
	void* get_phy_fb() { return m_phy_fb; }
	void* get_updated_fb(int* width, int* height, bool force_update = false)
	{
		if (width && height)
		{
			*width = m_width;
			*height = m_height;
		}
		if (force_update)
		{
			return m_phy_fb;
		}
		if (m_phy_read_index == m_phy_write_index)
		{//No update
			return 0;
		}
		m_phy_read_index = m_phy_write_index;
		return m_phy_fb;
	}
	int snap_shot(const char* file_name)
	{
		if (!m_phy_fb || (m_color_bytes !=2 && m_color_bytes != 4))
		{
			return -1;
		}
		//16 bits framebuffer
		if (m_color_bytes == 2)
		{
			return build_bmp(file_name, m_width, m_height, (unsigned char*)m_phy_fb);
		}
		//32 bits framebuffer
		unsigned short* p_bmp565_data = new unsigned short[m_width * m_height];
		unsigned int* p_raw_data = (unsigned int*)m_phy_fb;
		for (int i = 0; i < m_width * m_height; i++)
		{
			unsigned int rgb = *p_raw_data++;
			p_bmp565_data[i] = GL_RGB_32_to_16(rgb);
		}
		int ret = build_bmp(file_name, m_width, m_height, (unsigned char*)p_bmp565_data);
		delete[]p_bmp565_data;
		return ret;
	}
protected:
	virtual void draw_pixel(int x, int y, unsigned int rgb)
	{
		if ((x >= m_width) || (y >= m_height)) { return; }
		if (m_driver && m_driver->draw_pixel)
		{
			return m_driver->draw_pixel(x, y, rgb);
		}
		if (m_color_bytes == 2)
		{
			((unsigned short*)m_phy_fb)[y * m_width + x] = GL_RGB_32_to_16(rgb);
		}
		else
		{
			((unsigned int*)m_phy_fb)[y * m_width + x] = rgb;
		}
	}
	virtual void fill_rect(int x0, int y0, int x1, int y1, unsigned int rgb)
	{
		if (m_driver && m_driver->fill_rect)
		{
			return m_driver->fill_rect(x0, y0, x1, y1, rgb);
		}
		if (m_driver && m_driver->draw_pixel)
		{
			for (int y = y0; y <= y1; y++)
			{
				for (int x = x0; x <= x1; x++)
				{
					m_driver->draw_pixel(x, y, rgb);
				}
			}
			return;
		}
		register int _width = m_width;
		register int _height = m_height;
		int x, y;
		if (m_color_bytes == 2)
		{
			unsigned short* phy_fb;
			unsigned int rgb_16 = GL_RGB_32_to_16(rgb);
			for (y = y0; y <= y1; y++)
			{
				phy_fb = &((unsigned short*)m_phy_fb)[y * _width + x0];
				for (x = x0; x <= x1; x++)
				{
					if ((x < _width) && (y < _height))
					{
						*phy_fb++ = rgb_16;
					}
				}
			}
		}
		else
		{
			unsigned int* phy_fb;
			for (y = y0; y <= y1; y++)
			{
				phy_fb = &((unsigned int*)m_phy_fb)[y * _width + x0];
				for (x = x0; x <= x1; x++)
				{
					if ((x < _width) && (y < _height))
					{
						*phy_fb++ = rgb;
					}
				}
			}
		}
	}
	virtual int flush_screen(int left, int top, int right, int bottom, void* fb, int fb_width)
	{
		if ((0 == m_phy_fb) || (0 == fb))
		{
			return -1;
		}
		register int _width = m_width;
		register int _height = m_height;
		left = (left >= _width) ? (_width - 1) : left;
		right = (right >= _width) ? (_width - 1) : right;
		top = (top >= _height) ? (_height - 1) : top;
		bottom = (bottom >= _height) ? (_height - 1) : bottom;
		for (int y = top; y < bottom; y++)
		{
			void* s_addr = (char*)fb + ((y * fb_width + left) * m_color_bytes);
			void* d_addr = (char*)m_phy_fb + ((y * _width + left) * m_color_bytes);
			memcpy(d_addr, s_addr, (right - left) * m_color_bytes);
		}
		return 0;
	}
	int						m_width;		//in pixels
	int						m_height;		//in pixels
	int						m_color_bytes;	//16/32 bits for default
	void*					m_phy_fb;		//physical framebuffer for default
	struct DISPLAY_DRIVER*  m_driver;		//Rendering by external method without default physical framebuffer
	int				m_phy_read_index;
	int				m_phy_write_index;
	c_surface*		m_surface_group[SURFACE_CNT_MAX];
	int				m_surface_cnt;	//surface count
	int				m_surface_index;
	
};
class c_layer
{
public:
	c_layer() { fb = 0; }
	void* fb;		//framebuffer
	c_rect 	rect;	//framebuffer area
};
class c_surface {
	friend class c_display; friend class c_bitmap_operator;
public:
	c_surface(unsigned int width, unsigned int height, unsigned int color_bytes, Z_ORDER_LEVEL max_zorder = Z_ORDER_LEVEL_0, c_rect overlpa_rect = c_rect()) : m_width(width), m_height(height), m_color_bytes(color_bytes), m_fb(0), m_is_active(false), m_top_zorder(Z_ORDER_LEVEL_0), m_phy_write_index(0), m_display(0)
	{
		(overlpa_rect == c_rect()) ? set_surface(max_zorder, c_rect(0, 0, width - 1, height - 1)) : set_surface(max_zorder, overlpa_rect);
	}
	unsigned int get_pixel(int x, int y, unsigned int z_order)
	{
		if (x >= m_width || y >= m_height || x < 0 || y < 0 || z_order >= Z_ORDER_LEVEL_MAX)
		{
			ASSERT(false);
			return 0;
		}
		if (m_layers[z_order].fb)
		{
			return (m_color_bytes == 2) ? GL_RGB_16_to_32(((unsigned short*)(m_layers[z_order].fb))[y * m_width + x]) : ((unsigned int*)(m_layers[z_order].fb))[y * m_width + x];
		}
		else if (m_fb)
		{
			return (m_color_bytes == 2) ? GL_RGB_16_to_32(((unsigned short*)m_fb)[y * m_width + x]) : ((unsigned int*)m_fb)[y * m_width + x];
		}
		else if (m_display->m_phy_fb)
		{
			return (m_color_bytes == 2) ? GL_RGB_16_to_32(((unsigned short*)m_display->m_phy_fb)[y * m_width + x]) : ((unsigned int*)m_display->m_phy_fb)[y * m_width + x];
		}
		return 0;
	}
	virtual void draw_pixel(int x, int y, unsigned int rgb, unsigned int z_order)
	{
		if (x >= m_width || y >= m_height || x < 0 || y < 0)
		{
			return;
		}
		if (z_order > (unsigned int)m_max_zorder)
		{
			ASSERT(false);
			return;
		}
		if (z_order == m_max_zorder)
		{
			return draw_pixel_low_level(x, y, rgb);
		}
		
		if (z_order > (unsigned int)m_top_zorder)
		{
			m_top_zorder = (Z_ORDER_LEVEL)z_order;
		}
		if (m_layers[z_order].rect.pt_in_rect(x, y))
		{
			c_rect layer_rect = m_layers[z_order].rect;
			if (m_color_bytes == 2)
			{
				((unsigned short*)(m_layers[z_order].fb))[(x - layer_rect.m_left) + (y - layer_rect.m_top) * layer_rect.width()] = GL_RGB_32_to_16(rgb);
			}
			else
			{
				((unsigned int*)(m_layers[z_order].fb))[(x - layer_rect.m_left) + (y - layer_rect.m_top) * layer_rect.width()] = rgb;
			}
		}
		
		if (z_order == m_top_zorder)
		{
			return draw_pixel_low_level(x, y, rgb);
		}
		bool be_overlapped = false;
		for (unsigned int tmp_z_order = Z_ORDER_LEVEL_MAX - 1; tmp_z_order > z_order; tmp_z_order--)
		{
			if (m_layers[tmp_z_order].rect.pt_in_rect(x, y))
			{
				be_overlapped = true;
				break;
			}
		}
		if (!be_overlapped)
		{
			draw_pixel_low_level(x, y, rgb);
		}
	}
	virtual void fill_rect(int x0, int y0, int x1, int y1, unsigned int rgb, unsigned int z_order)
	{
		x0 = (x0 < 0) ? 0 : x0;
		y0 = (y0 < 0) ? 0 : y0;
		x1 = (x1 > (m_width - 1)) ? (m_width - 1) : x1;
		y1 = (y1 > (m_height - 1)) ? (m_height - 1) : y1;
		if (z_order == m_max_zorder)
		{
			return fill_rect_low_level(x0, y0, x1, y1, rgb);
		}
		if (z_order == m_top_zorder)
		{
			int x, y;
			c_rect layer_rect = m_layers[z_order].rect;
			unsigned int rgb_16 = GL_RGB_32_to_16(rgb);
			for (y = y0; y <= y1; y++)
			{
				for (x = x0; x <= x1; x++)
				{
					if (layer_rect.pt_in_rect(x, y))
					{
						if (m_color_bytes == 2)
						{
							((unsigned short*)m_layers[z_order].fb)[(y - layer_rect.m_top) * layer_rect.width() + (x - layer_rect.m_left)] = rgb_16;
						}
						else
						{
							((unsigned int*)m_layers[z_order].fb)[(y - layer_rect.m_top) * layer_rect.width() + (x - layer_rect.m_left)] = rgb;	
						}
					}
				}
			}
			return fill_rect_low_level(x0, y0, x1, y1, rgb);
		}
		for (; y0 <= y1; y0++)
		{
			draw_hline(x0, x1, y0, rgb, z_order);
		}
	}
	void draw_hline(int x0, int x1, int y, unsigned int rgb, unsigned int z_order)
	{
		for (; x0 <= x1; x0++)
		{
			draw_pixel(x0, y, rgb, z_order);
		}
	}
	void draw_vline(int x, int y0, int y1, unsigned int rgb, unsigned int z_order)
	{
		for (; y0 <= y1; y0++)
		{
			draw_pixel(x, y0, rgb, z_order);
		}
	}
	void draw_line(int x1, int y1, int x2, int y2, unsigned int rgb, unsigned int z_order)
	{
		int dx, dy, x, y, e;
		(x1 > x2) ? (dx = x1 - x2) : (dx = x2 - x1);
		(y1 > y2) ? (dy = y1 - y2) : (dy = y2 - y1);
		if (((dx > dy) && (x1 > x2)) || ((dx <= dy) && (y1 > y2)))
		{
			x = x2; y = y2;
			x2 = x1; y2 = y1;
			x1 = x; y1 = y;
		}
		x = x1; y = y1;
		if (dx > dy)
		{
			e = dy - dx / 2;
			for (; x1 <= x2; ++x1, e += dy)
			{
				draw_pixel(x1, y1, rgb, z_order);
				if (e > 0) { e -= dx; (y > y2) ? --y1 : ++y1; }
			}
		}
		else
		{
			e = dx - dy / 2;
			for (; y1 <= y2; ++y1, e += dx)
			{
				draw_pixel(x1, y1, rgb, z_order);
				if (e > 0) { e -= dy; (x > x2) ? --x1 : ++x1; }
			}
		}
	}
	void draw_rect(int x0, int y0, int x1, int y1, unsigned int rgb, unsigned int z_order, unsigned int size = 1)
	{
		for (unsigned int offset = 0; offset < size; offset++)
		{
			draw_hline(x0 + offset, x1 - offset, y0 + offset, rgb, z_order);
			draw_hline(x0 + offset, x1 - offset, y1 - offset, rgb, z_order);
			draw_vline(x0 + offset, y0 + offset, y1 - offset, rgb, z_order);
			draw_vline(x1 - offset, y0 + offset, y1 - offset, rgb, z_order);
		}
	}
	void draw_rect(c_rect rect, unsigned int rgb, unsigned int size, unsigned int z_order)
	{
		draw_rect(rect.m_left, rect.m_top, rect.m_right, rect.m_bottom, rgb, z_order, size);
	}
	void fill_rect(c_rect rect, unsigned int rgb, unsigned int z_order)
	{
		fill_rect(rect.m_left, rect.m_top, rect.m_right, rect.m_bottom, rgb, z_order);
	}
	int flush_screen(int left, int top, int right, int bottom)
	{
		if (!m_is_active)
		{
			return -1;
		}
		if (left < 0 || left >= m_width || right < 0 || right >= m_width ||
			top < 0 || top >= m_height || bottom < 0 || bottom >= m_height)
		{
			ASSERT(false);
		}
		m_display->flush_screen(left, top, right, bottom, m_fb, m_width);
		*m_phy_write_index = *m_phy_write_index + 1;
		return 0;
	}
	bool is_active() { return m_is_active; }
	c_display* get_display() { return m_display; }
	int show_layer(c_rect& rect, unsigned int z_order)
	{
		ASSERT(z_order >= Z_ORDER_LEVEL_0 && z_order < Z_ORDER_LEVEL_MAX);
		c_rect layer_rect = m_layers[z_order].rect;
		ASSERT(rect.m_left >= layer_rect.m_left && rect.m_right <= layer_rect.m_right &&
			rect.m_top >= layer_rect.m_top && rect.m_bottom <= layer_rect.m_bottom);
		void* fb = m_layers[z_order].fb;
		int width = layer_rect.width();
		for (int y = rect.m_top; y <= rect.m_bottom; y++)
		{
			for (int x = rect.m_left; x <= rect.m_right; x++)
			{
				unsigned int rgb = (m_color_bytes == 2) ? GL_RGB_16_to_32(((unsigned short*)fb)[(x - layer_rect.m_left) + (y - layer_rect.m_top) * width]) : ((unsigned int*)fb)[(x - layer_rect.m_left) + (y - layer_rect.m_top) * width];
				draw_pixel_low_level(x, y, rgb);
			}
		}
		return 0;
	}
	void set_active(bool flag) { m_is_active = flag; }
protected:
	virtual void fill_rect_low_level(int x0, int y0, int x1, int y1, unsigned int rgb)
	{//fill rect on framebuffer of surface
		int x, y;
		if (m_color_bytes == 2)
		{
			unsigned short* fb;
			unsigned int rgb_16 = GL_RGB_32_to_16(rgb);
			for (y = y0; y <= y1; y++)
			{
				fb = m_fb ? &((unsigned short*)m_fb)[y * m_width + x0] : 0;
				if (!fb) { break; }
				for (x = x0; x <= x1; x++)
				{
					*fb++ = rgb_16;
				}
			}
		}
		else
		{
			unsigned int* fb;
			for (y = y0; y <= y1; y++)
			{
				fb = m_fb ? &((unsigned int*)m_fb)[y * m_width + x0] : 0;
				if (!fb) { break; }
				for (x = x0; x <= x1; x++)
				{
					*fb++ = rgb;
				}
			}
		}
		if (!m_is_active) { return; }
		m_display->fill_rect(x0, y0, x1, y1, rgb);
		*m_phy_write_index = *m_phy_write_index + 1;
	}
	virtual void draw_pixel_low_level(int x, int y, unsigned int rgb)
	{
		if (m_fb)
		{//draw pixel on framebuffer of surface
			(m_color_bytes == 2) ? ((unsigned short*)m_fb)[y * m_width + x] = GL_RGB_32_to_16(rgb): ((unsigned int*)m_fb)[y * m_width + x] = rgb;
		}
		if (!m_is_active) { return; }
		m_display->draw_pixel(x, y, rgb);
		*m_phy_write_index = *m_phy_write_index + 1;
	}
	void attach_display(c_display* display)
	{
		ASSERT(display);
		m_display = display;
		m_phy_write_index = &display->m_phy_write_index;
	}
	void set_surface(Z_ORDER_LEVEL max_z_order, c_rect layer_rect)
	{
		m_max_zorder = max_z_order;
		if (m_display && (m_display->m_surface_cnt > 1))
		{
			m_fb = calloc(m_width * m_height, m_color_bytes);
		}
		for (int i = Z_ORDER_LEVEL_0; i < m_max_zorder; i++)
		{//Top layber fb always be 0
			ASSERT(m_layers[i].fb = calloc(layer_rect.width() * layer_rect.height(), m_color_bytes));
			m_layers[i].rect = layer_rect;
		}
	}
	int				m_width;		//in pixels
	int				m_height;		//in pixels
	int				m_color_bytes;	//16 bits, 32 bits for default
	void*			m_fb;			//frame buffer you could see
	c_layer 		m_layers[Z_ORDER_LEVEL_MAX];//all graphic layers
	bool			m_is_active;	//active flag
	Z_ORDER_LEVEL	m_max_zorder;	//the highest graphic layer the surface will have
	Z_ORDER_LEVEL	m_top_zorder;	//the current highest graphic layer the surface have
	int*			m_phy_write_index;
	c_display*		m_display;
};
inline c_display::c_display(void* phy_fb, int display_width, int display_height, c_surface* surface, DISPLAY_DRIVER* driver) : m_phy_fb(phy_fb), m_width(display_width), m_height(display_height), m_driver(driver), m_phy_read_index(0), m_phy_write_index(0), m_surface_cnt(1), m_surface_index(0)
{
	m_color_bytes = surface->m_color_bytes;
	surface->m_is_active = true;
	(m_surface_group[0] = surface)->attach_display(this);
}
inline c_display::c_display(void* phy_fb, int display_width, int display_height, int surface_width, int surface_height, unsigned int color_bytes, int surface_cnt, DISPLAY_DRIVER* driver) : m_phy_fb(phy_fb), m_width(display_width), m_height(display_height), m_color_bytes(color_bytes), m_phy_read_index(0), m_phy_write_index(0), m_surface_cnt(surface_cnt), m_driver(driver), m_surface_index(0)
{
	ASSERT(color_bytes == 2 || color_bytes == 4);
	ASSERT(m_surface_cnt <= SURFACE_CNT_MAX);
	memset(m_surface_group, 0, sizeof(m_surface_group));
	
	for (int i = 0; i < m_surface_cnt; i++)
	{
		m_surface_group[i] = new c_surface(surface_width, surface_height, color_bytes);
		m_surface_group[i]->attach_display(this);
	}
}
inline c_surface* c_display::alloc_surface(Z_ORDER_LEVEL max_zorder, c_rect layer_rect)
{
	ASSERT(max_zorder < Z_ORDER_LEVEL_MAX && m_surface_index < m_surface_cnt);
	(layer_rect == c_rect()) ? m_surface_group[m_surface_index]->set_surface(max_zorder, c_rect(0, 0, m_width - 1, m_height - 1)) : m_surface_group[m_surface_index]->set_surface(max_zorder, layer_rect);
	return m_surface_group[m_surface_index++];
}
inline int c_display::swipe_surface(c_surface* s0, c_surface* s1, int x0, int x1, int y0, int y1, int offset)
{
	register int surface_width = s0->m_width;
	register int surface_height = s0->m_height;
	if (offset < 0 || offset > surface_width || y0 < 0 || y0 >= surface_height ||
		y1 < 0 || y1 >= surface_height || x0 < 0 || x0 >= surface_width || x1 < 0 || x1 >= surface_width)
	{
		ASSERT(false);
		return -1;
	}
	int width = (x1 - x0 + 1);
	if (width < 0 || width > surface_width || width < offset)
	{
		ASSERT(false);
		return -1;
	}
	x0 = (x0 >= m_width) ? (m_width - 1) : x0;
	x1 = (x1 >= m_width) ? (m_width - 1) : x1;
	y0 = (y0 >= m_height) ? (m_height - 1) : y0;
	y1 = (y1 >= m_height) ? (m_height - 1) : y1;
	if (m_phy_fb)
	{
		for (int y = y0; y <= y1; y++)
		{
			//Left surface
			char* addr_s = ((char*)(s0->m_fb) + (y * surface_width + x0 + offset) * m_color_bytes);
			char* addr_d = ((char*)(m_phy_fb)+(y * m_width + x0) * m_color_bytes);
			memcpy(addr_d, addr_s, (width - offset) * m_color_bytes);
			//Right surface
			addr_s = ((char*)(s1->m_fb) + (y * surface_width + x0) * m_color_bytes);
			addr_d = ((char*)(m_phy_fb)+(y * m_width + x0 + (width - offset)) * m_color_bytes);
			memcpy(addr_d, addr_s, offset * m_color_bytes);
		}
	}
	else if (m_color_bytes == 2)
	{
		void(*draw_pixel)(int x, int y, unsigned int rgb) = m_driver->draw_pixel;
		for (int y = y0; y <= y1; y++)
		{
			//Left surface
			for (int x = x0; x <= (x1 - offset); x++)
			{
				draw_pixel(x, y, GL_RGB_16_to_32(((unsigned short*)s0->m_fb)[y * m_width + x + offset]));
			}
			//Right surface
			for (int x = x1 - offset; x <= x1; x++)
			{
				draw_pixel(x, y, GL_RGB_16_to_32(((unsigned short*)s1->m_fb)[y * m_width + x + offset - x1 + x0]));
			}
		}
	}
	else //m_color_bytes == 3/4...
	{
		void(*draw_pixel)(int x, int y, unsigned int rgb) = m_driver->draw_pixel;
		for (int y = y0; y <= y1; y++)
		{
			//Left surface
			for (int x = x0; x <= (x1 - offset); x++)
			{
				draw_pixel(x, y, ((unsigned int*)s0->m_fb)[y * m_width + x + offset]);
			}
			//Right surface
			for (int x = x1 - offset; x <= x1; x++)
			{
				draw_pixel(x, y, ((unsigned int*)s1->m_fb)[y * m_width + x + offset - x1 + x0]);
			}
		}
	}
	m_phy_write_index++;
	return 0;
}
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
