bald-prince/STM32/(notices)

Notices in the files:
IIC/SYSTEM/sys/sys.c:
Copyright(C) ¹ãÖÝÊÐÐÇÒíµç×Ó¿Æ¼¼ÓÐÏÞ¹«Ë¾ 2014-2024
All rights reserved
STM32_sumjess/HAREWARE/WKUP/wkup.c:
Copyright(C) ¹ãÖÝÊÐÐÇÒíµç×Ó¿Æ¼¼ÓÐÏÞ¹«Ë¾ 2009-2019
STM32_sumjess/USMART/usmart.c:
Copyright(C) ÕýµãÔ­×Ó 2011-2021
